MDalprato/Bracccio-robotico-automatizzabile/Arm control/Interfaccia USB/fotone2_schematic.png

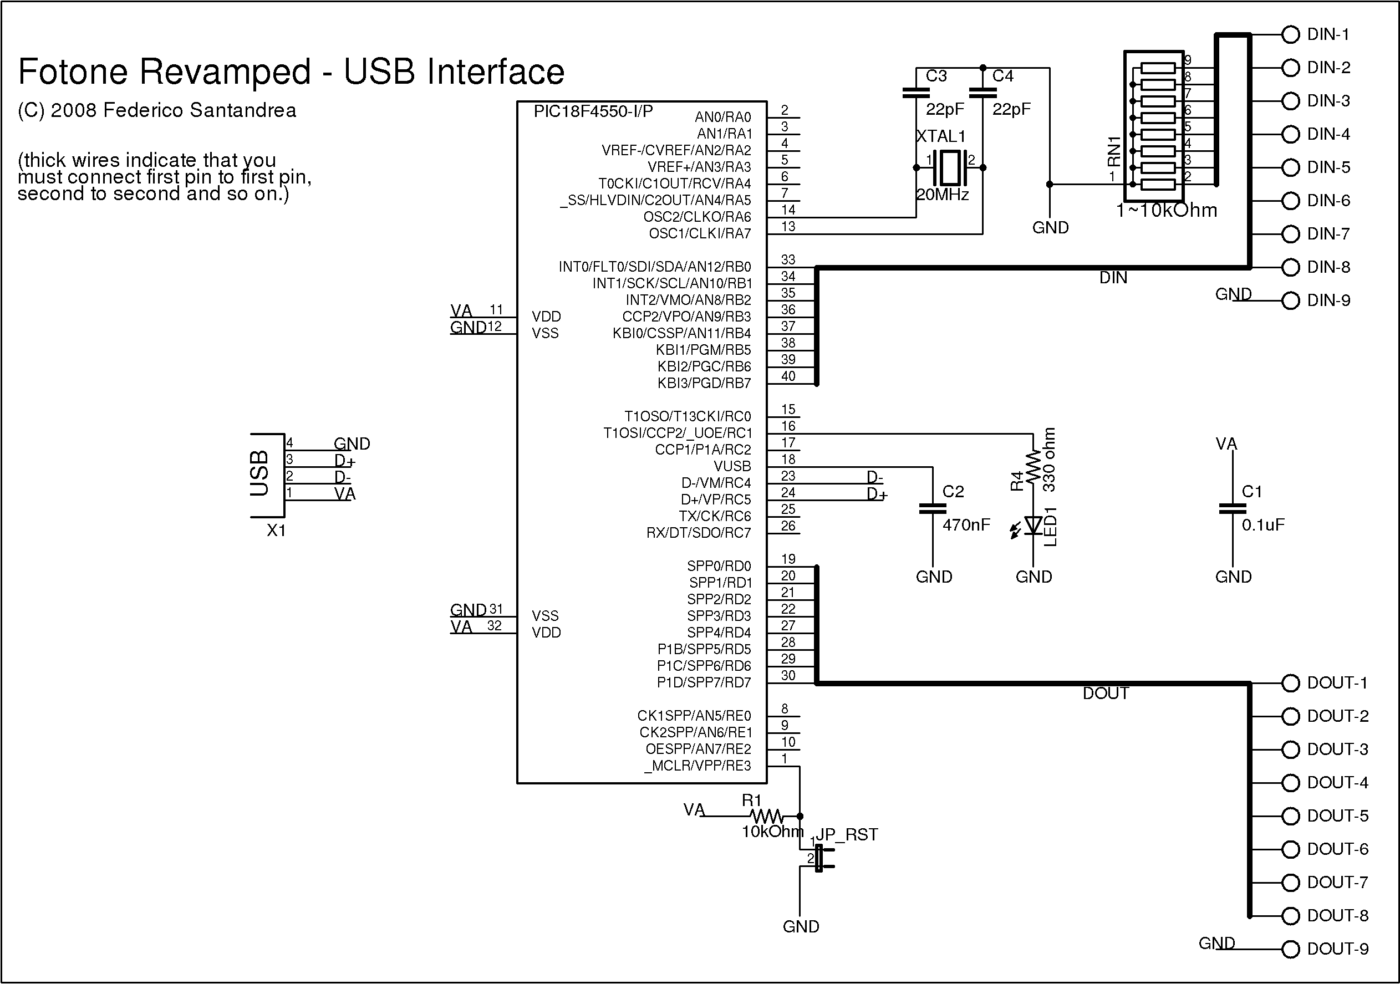
Arm control/Interfaccia USB/fotone2_schematic.png
