MDalprato/Bracccio-robotico-automatizzabile/Arm control/Interfaccia USB/Info/index_files/fotone.png

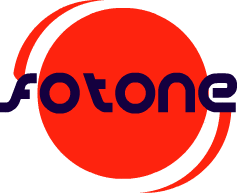
Arm control/Interfaccia USB/Info/index_files/fotone.png
