MDalprato/Bracccio-robotico-automatizzabile/Arm control/Interfaccia USB/Interfaccia USB3_BUONO.bmp

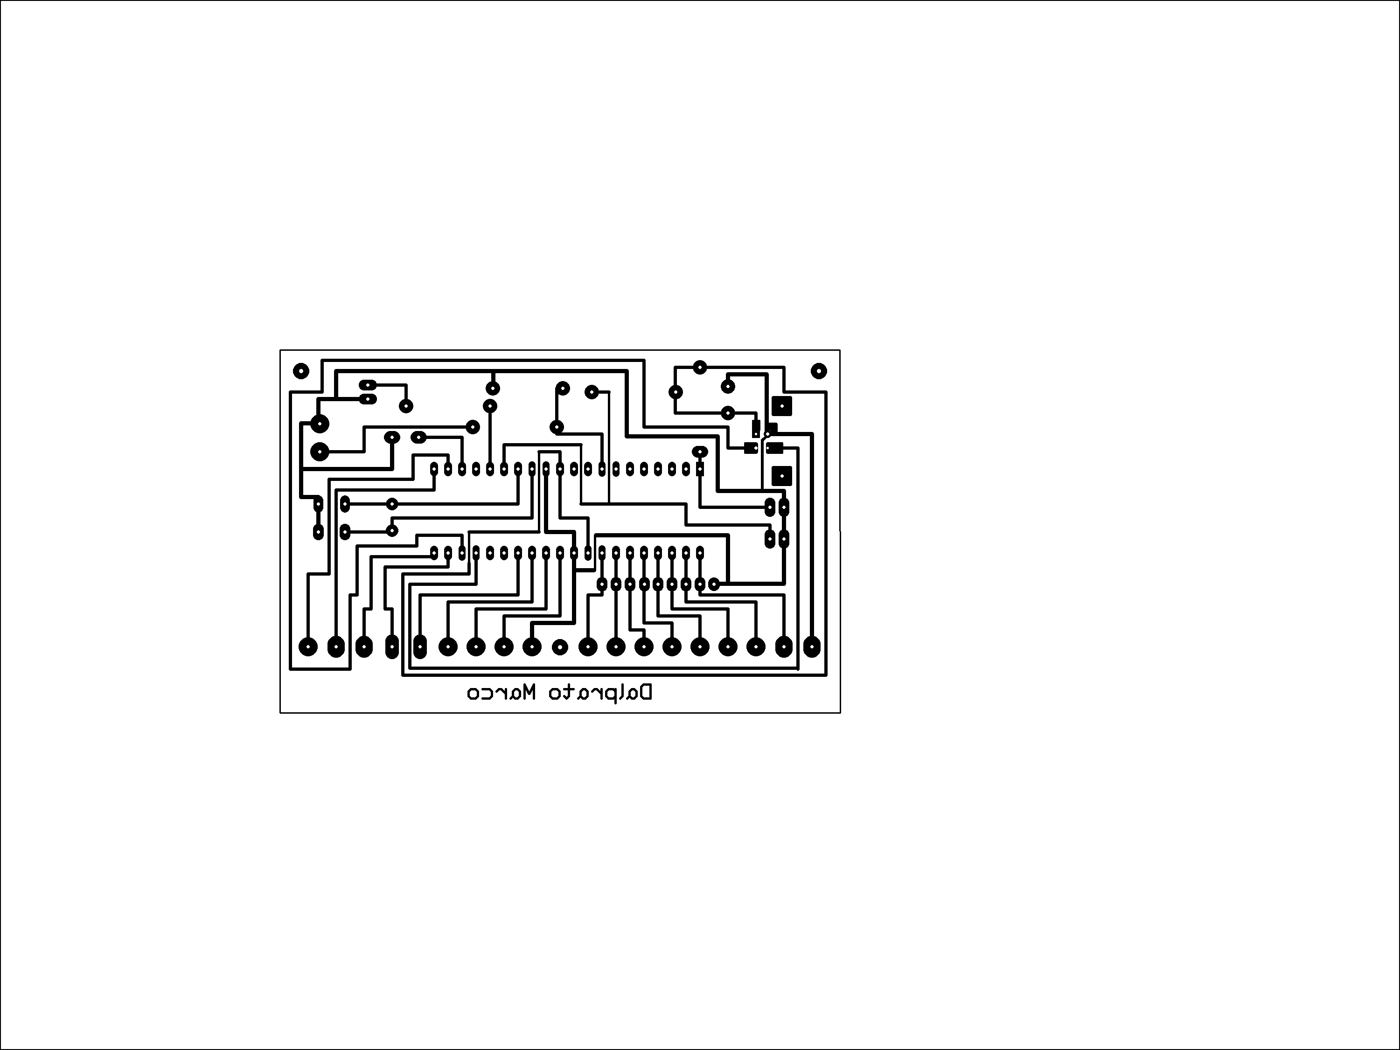
Arm control/Interfaccia USB/Interfaccia USB3_BUONO.bmp
