MDalprato/Bracccio-robotico-automatizzabile/Arm control/tutto quello che ho usato/g_03870680_002.jpg

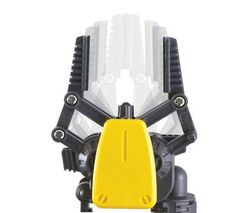
Arm control/tutto quello che ho usato/g_03870680_002.jpg
