MDalprato/Bracccio-robotico-automatizzabile/Arm control/tutto quello che ho usato/key.jpg

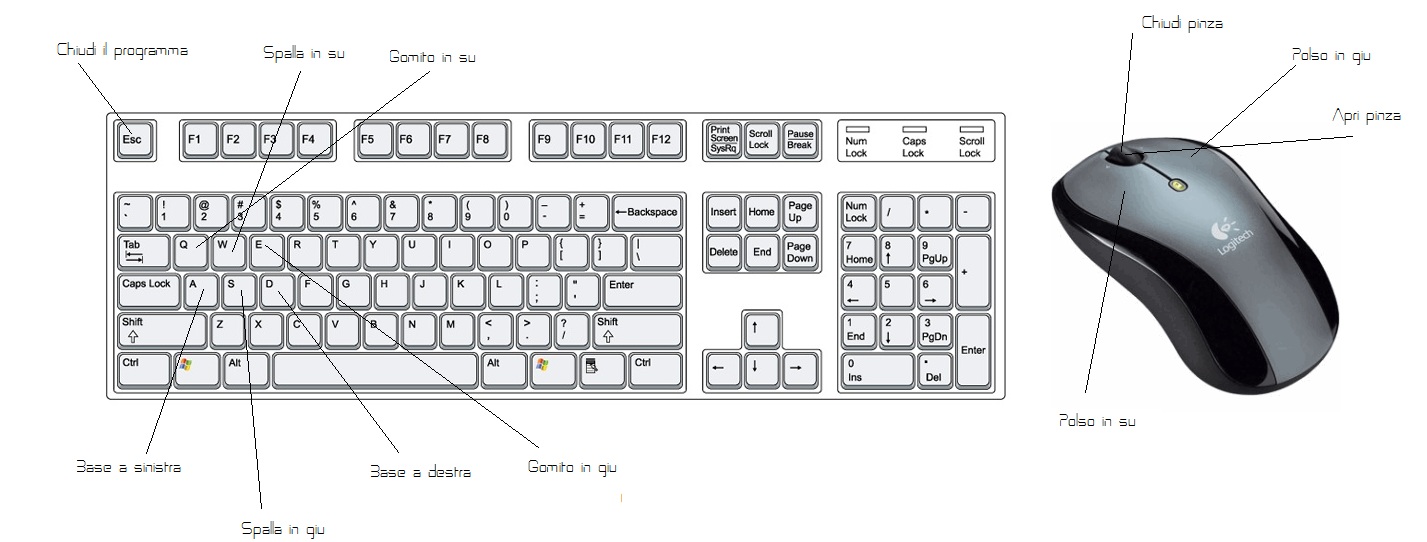
Arm control/tutto quello che ho usato/key.jpg
