MDalprato/Bracccio-robotico-automatizzabile/Arm control/tutto quello che ho usato/mouse-scroll-wheel.jpg

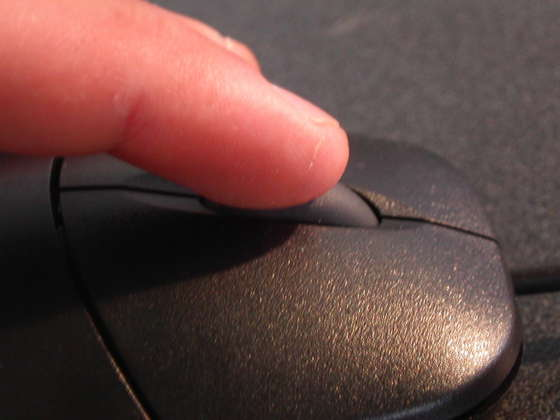
Arm control/tutto quello che ho usato/mouse-scroll-wheel.jpg
