MDalprato/Bracccio-robotico-automatizzabile/Arm control/tutto quello che ho usato/usb_3.0_cables.jpg

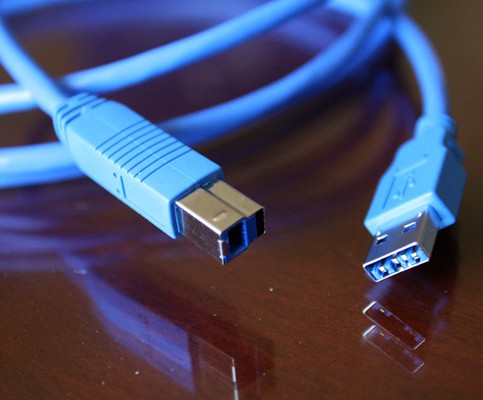
Arm control/tutto quello che ho usato/usb_3.0_cables.jpg
