MDalprato/Bracccio-robotico-automatizzabile/Assets/1.jpg

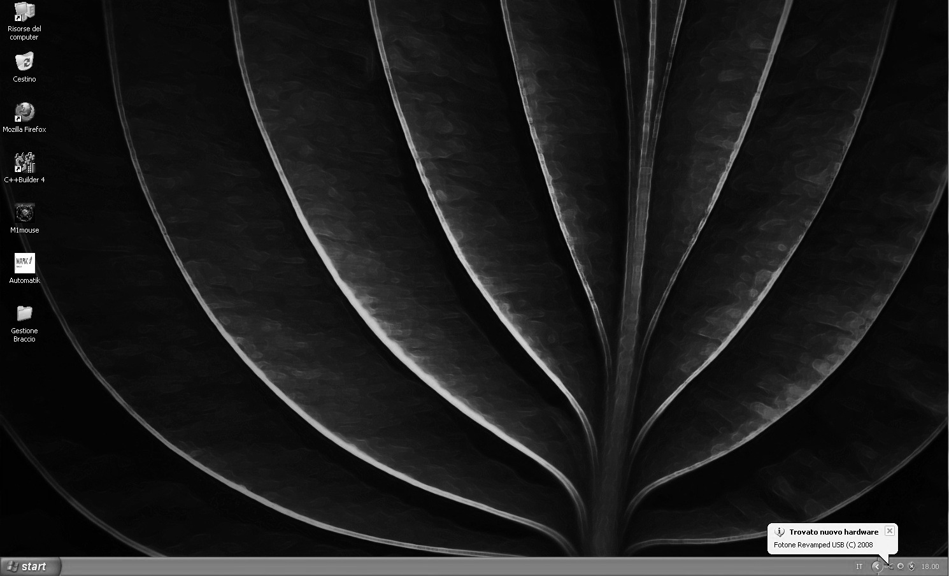
Assets/1.jpg
