MDalprato/Bracccio-robotico-automatizzabile/Assets/2.jpg

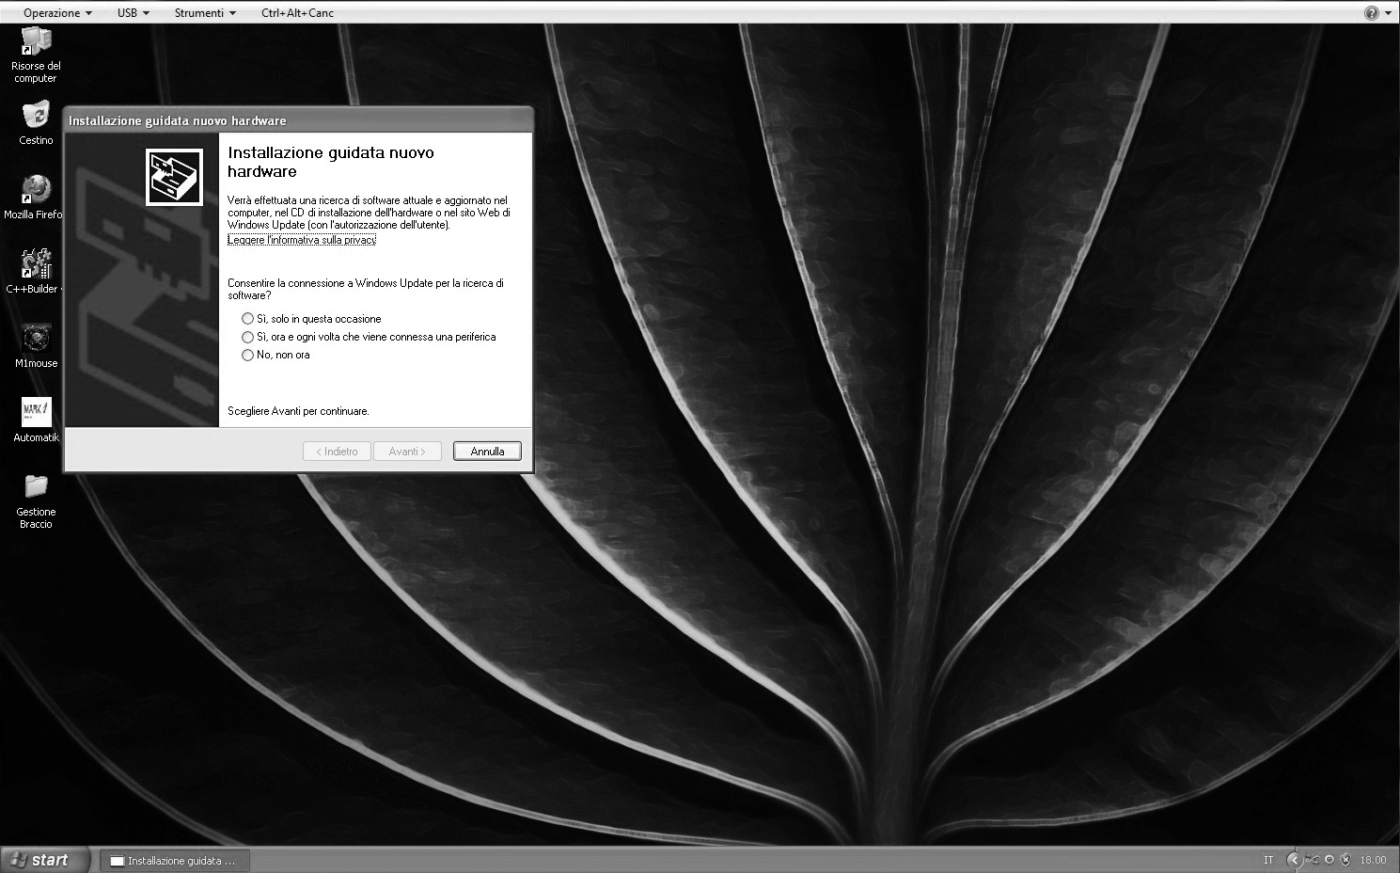
Assets/2.jpg
