MDalprato/Bracccio-robotico-automatizzabile/Assets/5.jpg

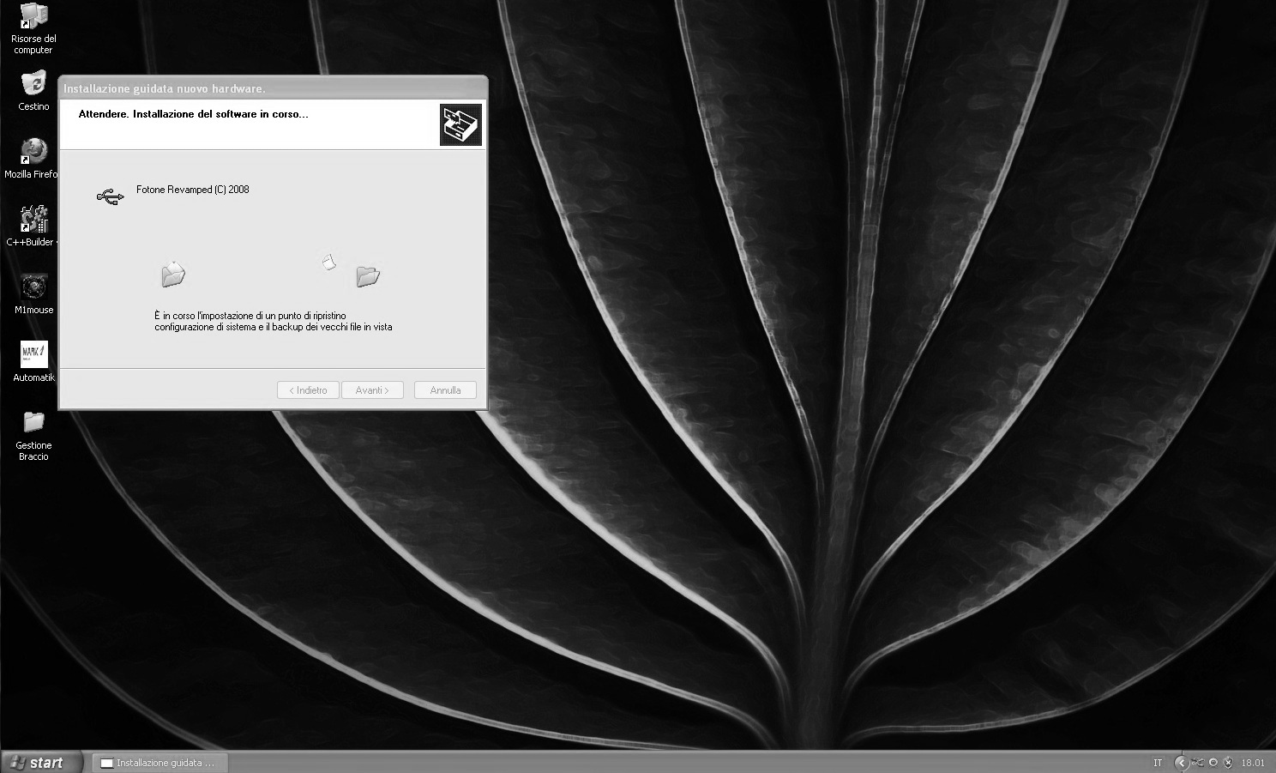
Assets/5.jpg
