MDalprato/Bracccio-robotico-automatizzabile/Files/4-9610.jpg

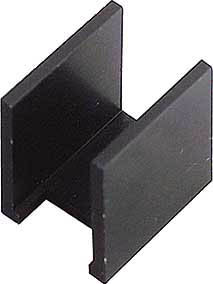
Files/4-9610.jpg
