MDalprato/Bracccio-robotico-automatizzabile/Schemi tesina/schema a blocchi.jpg

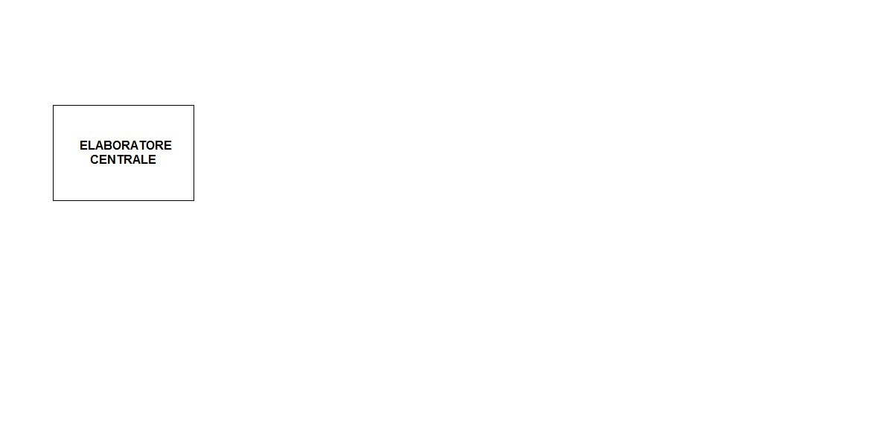
Schemi tesina/schema a blocchi.jpg
