MDalprato/Bracccio-robotico-automatizzabile/undfmed.jpg

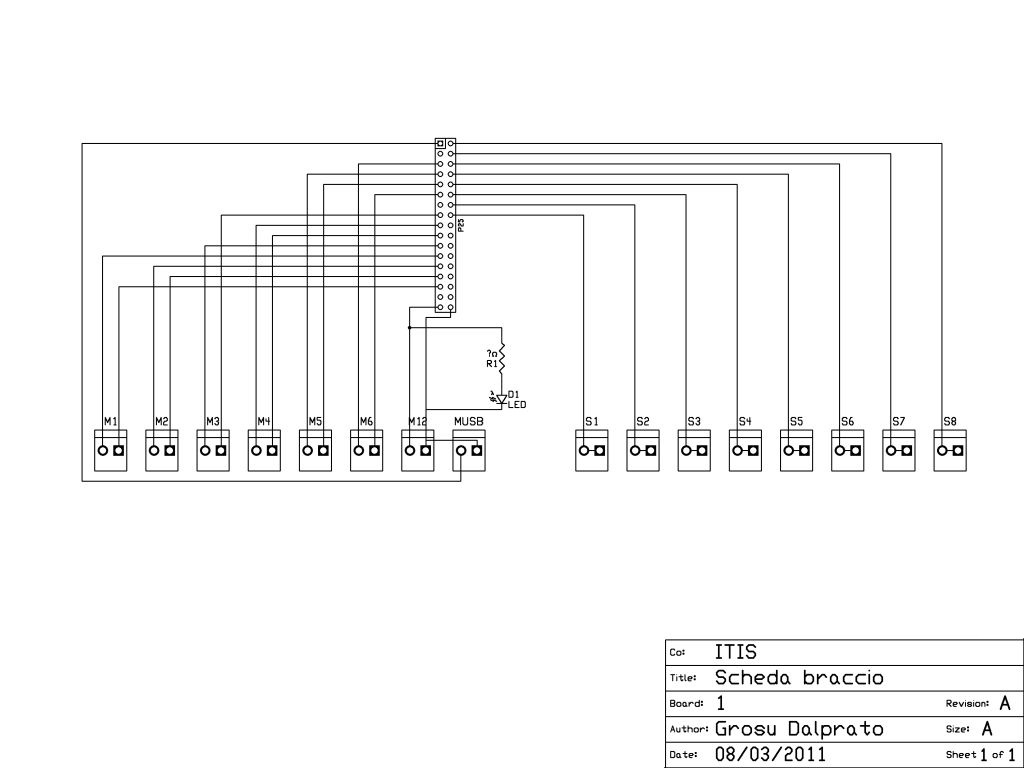
undfmed.jpg
