MDalprato/Bracccio-robotico-automatizzabile/(list of files, cad)

Other CAD files:
Arm control/Generale/Unit5.obj
Arm control/Via Automatismo/Unit3.obj
Binaries/Automatik.obj
Arm control/Generale/Unit1.obj
Arm control/Via Automatismo/Unit4.obj
Arm control/Generale/Unit7.obj
Arm control/Via Automatismo/Unit8.obj
Arm control/Generale/Unit3.obj
Arm control/Via Automatismo/Unit9.obj
Arm control/Generale/Unit4.obj
Arm control/Via Automatismo/Unit1.obj
Arm control/Generale/M1mouse.obj
Arm control/Via Automatismo/Unit2.obj
Arm control/Generale/Unit2.obj
Arm control/Via Automatismo/Unit5.obj
Arm control/Generale/Unit6.obj
Arm control/Via Automatismo/Unit6.obj
Arm control/Via Automatismo/Unit7.obj
