MDalprato/Bracccio-robotico-automatizzabile/(list of files, drawings)

Other design files:
Arm control/Interfaccia USB/Interfaccia USB3_BUONO.pcb
Arm control/Interfaccia USB/Mosfet di potenza.pcb
Files/PCB CORRETTO E DEFINITIVO 11 marzo/Braccio pcb/unnamed.pcb
Files/PCB CORRETTO E DEFINITIVO 11 marzo/Interfaccia USB/Interfaccia USB3_BUONO.pcb
Files/PCB CORRETTO E DEFINITIVO 11 marzo/Motherboard/unnamed.pcb
PCB/Complete PCB/Braccio pcb/unnamed.pcb
PCB/Complete PCB/Interfaccia USB3_BUONO.pcb
PCB/Complete PCB/Motherboard/unnamed.pcb
PCB/unnamed.pcb
